TAMS-Group/tams_tactile_sensor_array_hardware/electronics/sensor_module/PCB/BOM_Tactile_Array V1.1.csv

ID | Name | Designator | Footprint | Quantity | Manufacturer Part | Manufacturer | Supplier | Supplier Part
1 | 1uF | C1,C9 | C0603 | 2
2 | 20pF | C2,C3 | C0603 | 2
3 | 100nF | C4,C5,C6,C7,C8 | C0603 | 5
4 | B4B-ZR (LF)(SN) | CN1 | CONN-TH_B4B-ZR (LF)(SN) | 1
5 | B2B-ZR-3.4 (LF)(SN) | CN2 | CONN-TH_B2B-ZR-3.4 (LF)(SN) | 1
6 | Connector | CN3 | CONN-TH_B4B-ZR (LF)(SN) HOLES ONLY | 1
7 | WS2812C | LED1 | LED-SMD_4P-L5.0-W5.0-TL | 1
8 | 10K | R1,R2,R3,R4,R5,R6,R7,R8,R9 | R0603 | 9
9 | ATMEGA328P-AU | U1 | TQFP-32_L7.0-W7.0-P0.80-LS9.0-BL | 1
10 | LMV324IPWR | U2 | TSSOP-14_L5.0-W4.4-P0.65-LS6.4-BL | 1
11 | LMV358IPWR | U3 | TSSOP-8_L4.4-W3.0-P0.65-LS6.4-BL | 1
12 | 16MHz | X2 | OSC-SMD_4P-L3.2-W2.5-BL | 1
