TAMS-Group/tams_tactile_sensor_array_hardware/parts/finger_out.stl

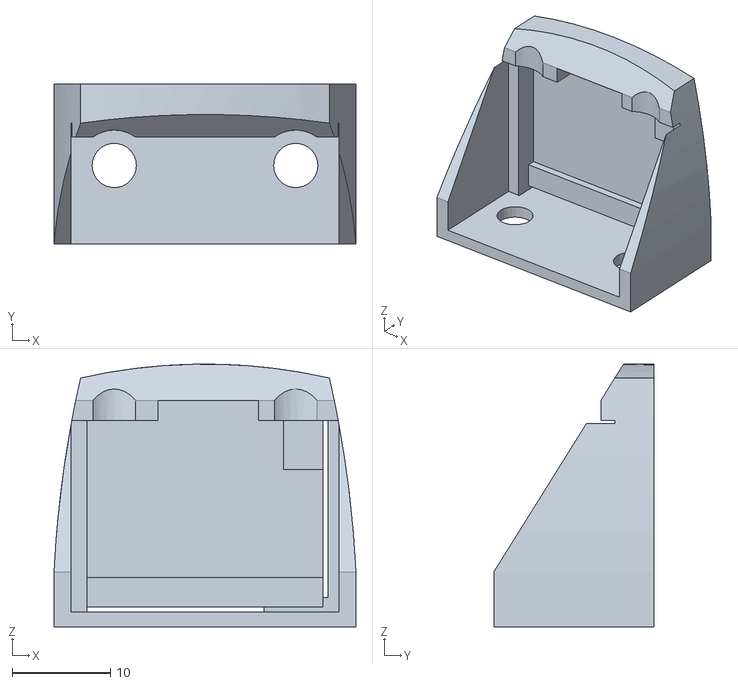
[picture p1: CAD file, 2021-03-15]
parts/finger_out.stl
30.7 x 16.3 x 26.7
