TAMS-Group/tams_tactile_sensor_array_hardware/parts/finger_in.stl

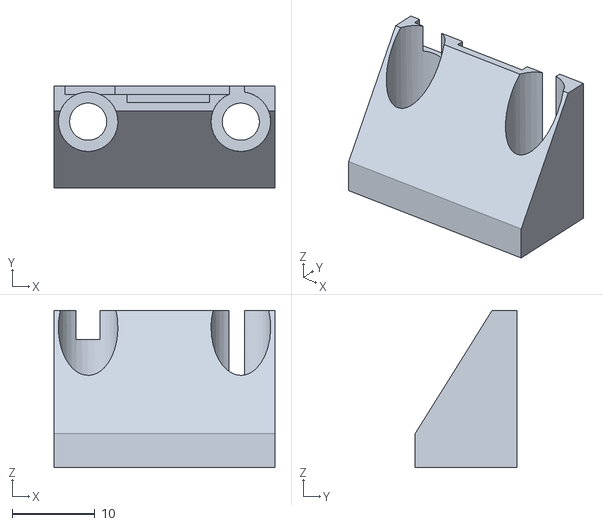
[picture p2: CAD file, 2021-03-15]
parts/finger_in.stl
26.7 x 12.3 x 19.0
