TAMS-Group/tams_tactile_sensor_array_hardware/electronics/sensor_module/schematic.pdf

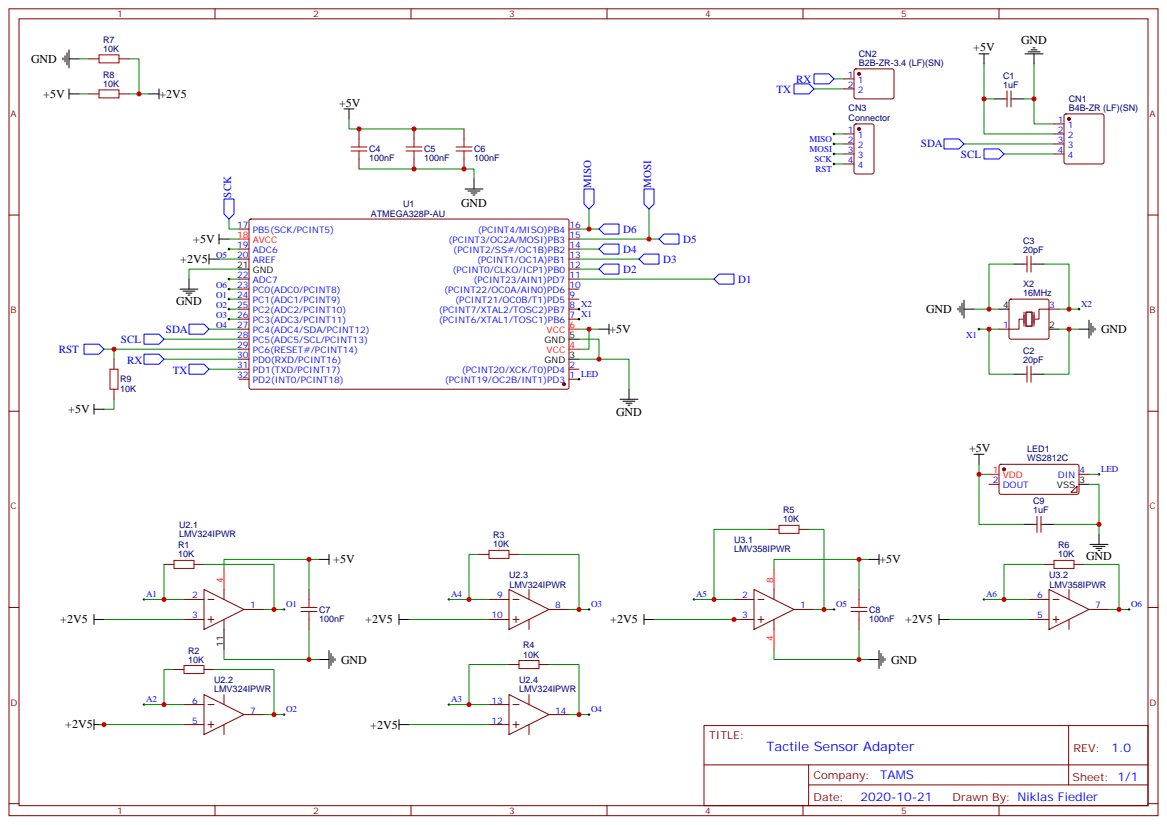
[picture p3: page 1]

Drawn By: Niklas Fiedler
