TAMS-Group/tams_tactile_sensor_array_hardware/calibration/calibration2.txt

no weight: 1660130
20g weight: 1667333
tip: 6mm cylinder
resistance: 10kOhm
