TAMS-Group/tams_tactile_sensor_array_hardware/calibration/tactile_calibration_plots.png

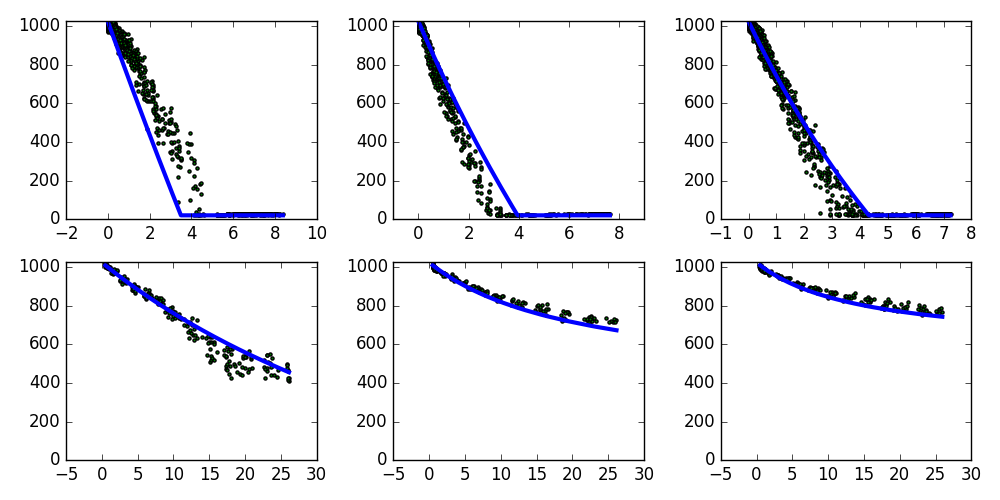
calibration/tactile_calibration_plots.png
